apfaudio/soldiercrab/(notices)

Notices in the files:
soldiercrab.kicad_sch:
Licensed under the CERN-OHL-S v2
